cmanna75/BirdBox/(commit log)

2023-03-28 cleaned up ultrasonic code
2023-04-05 When pressure sensor board not connected, red LED
2023-04-06 servo pwm
2023-04-06 changed ultrasonic to timer0
2023-04-13 ultrasonic control of video
2023-04-20 all buttons working, just looks a lil ugly
2023-04-20 all buttons/sensors working, cleaned up ui
2023-04-20 adc somewhat
